jerabaul29/LoggerWavesInIce/Logger_GPS_SD_VN_Binary_output/README.txt

This is a modified version of the code used in 2016, that implements one solution that can be used to perform logging of binary data from the VN100. This could be adapted to log other binary outputs. 

---------------------------------------------------------------
This logger uses:
- the VN100 with binary output
- the GPS with usual serial output
---------------------------------------------------------------

---------------------------------------------------------------
The configuration of the VN100 is:

Baud rate      : 57600
Async          : NoOutput
Binary output 1: 
    Async mode    : Serial Port 1
    Rate dividor  : 80
    Common group  : None
    IMU group     : UncompensatedMag
                    UncompensatedAccel
                    UncompensatedGyro
                    Temp
                    Press
    Attitude group: Yaw Pitch Roll
                    DCM
                    MagNed
                    AccelNed
    IMU filtering : 80
 
 This corresponds to the binary header (in HEX):
 fa 14 3e 00 3a 00
 
 The length of the message is (in byte): 123
 
 Note that the post can have in addition an
 end of line marker (in HEX):
 0a 0d
 ---------------------------------------------------------------
 
 ---------------------------------------------------------------
 To examine the content of the SD card on Linux computer,
 use for example xxd:
 
 tail -x FileName | head -y | xxd
 ---------------------------------------------------------------
 
 ---------------------------------------------------------------
 CAUTION: when using VectorNav software, do not forget to:
 - connect to the sensor
 - write to non volatile memory (right click on the sensor in the tree view)
 - disconnect from the sensor
 ---------------------------------------------------------------
 
 If you use a PCB from a waves in ice instrument, make sure to use the right port for the IMU (need Serial3), make sure to use a core with extended buffers (better to use RX as 512 bytes), and make sure that production loggers have the serial debug disabled.
