jerabaul29/LoggerWavesInIce/InitializeEEPROM/Readme.md

This sketch should be uploaded and run once before an Arduino board will be used for logging. This will initialize the EEPROM memory location used for tracking file numbering.

Once this sketch has been uploaded on the board (and let run once), you can upload the code for the logger on the board.
