jerabaul29/LoggerWavesInIce/Logger_GPS_SD_VN/Readme.md

This is the program uploaded on the Arduino board that was used for performing measurements during the year 2016.
