jerabaul29/LoggerWavesInIce/UserManual/MainManual/Figures/IMG_20170418_100254.jpg

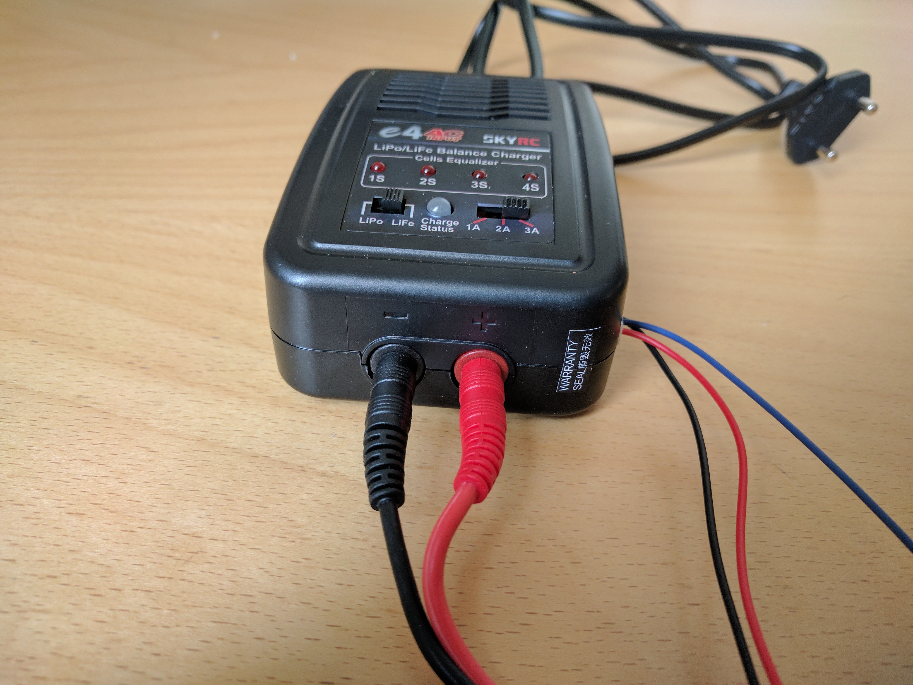
UserManual/MainManual/Figures/IMG_20170418_100254.jpg
