jerabaul29/LoggerWavesInIce/UserManual/MainManual/Figures/IMG_20170418_100300.jpg

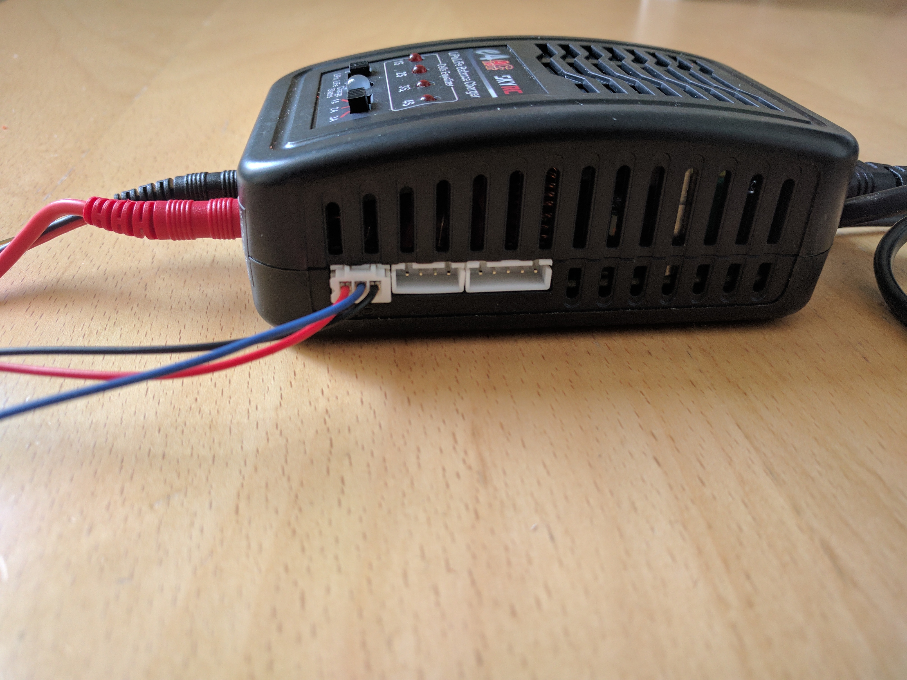
UserManual/MainManual/Figures/IMG_20170418_100300.jpg
