jerabaul29/LoggerWavesInIce/UserManual/MainManual/Figures/IMG_20170418_102035.jpg

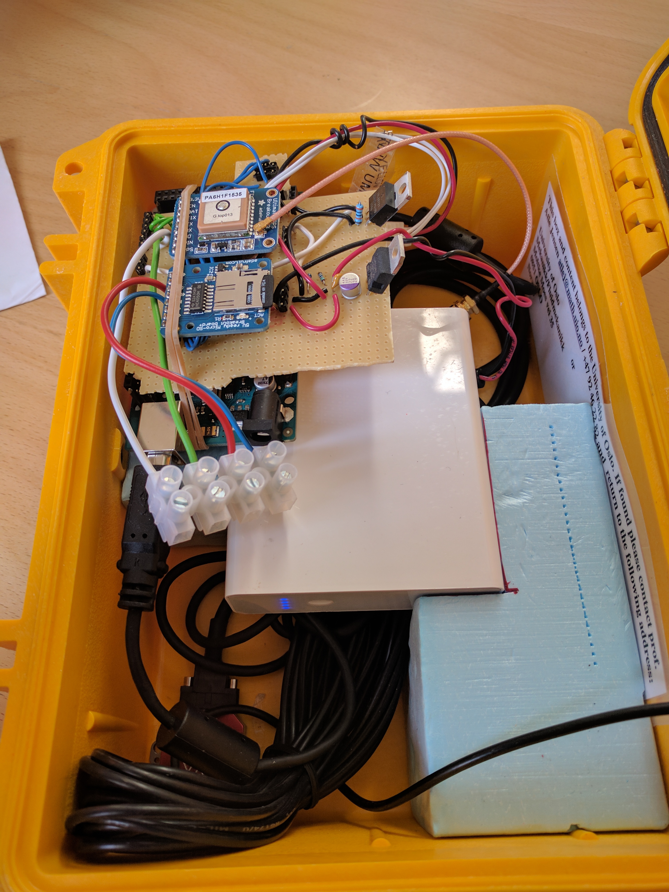
UserManual/MainManual/Figures/IMG_20170418_102035.jpg
