jerabaul29/LoggerWavesInIce/UserManual/MainManual/Figures/IMG_20170418_102041.jpg

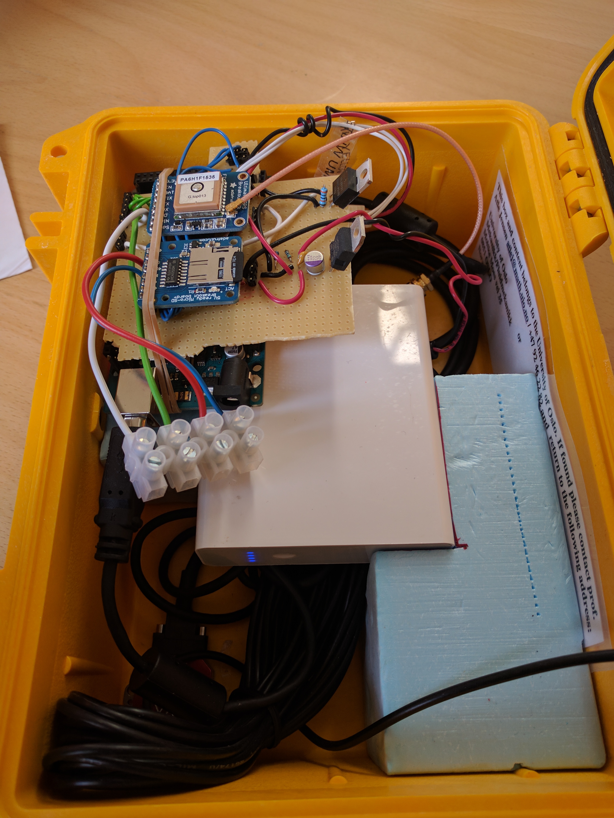
UserManual/MainManual/Figures/IMG_20170418_102041.jpg
