jerabaul29/LoggerWavesInIce/UserManual/MainManual/Figures/IMG_20170418_102318.jpg

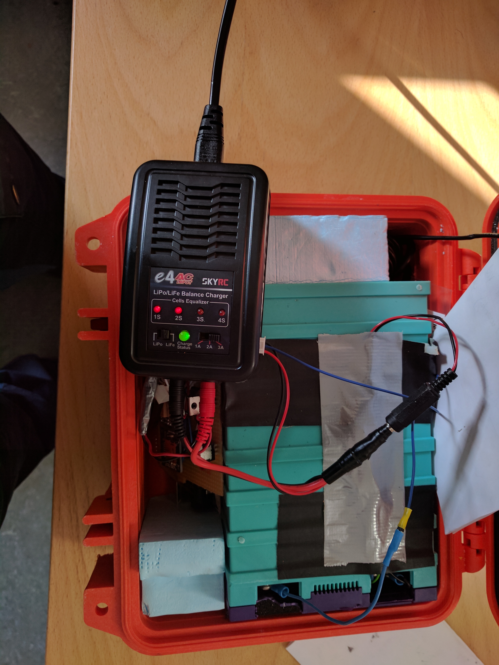
UserManual/MainManual/Figures/IMG_20170418_102318.jpg
