jerabaul29/LoggerWavesInIce/UserManual/MainManual/Figures/IMG_20170418_134233.jpg

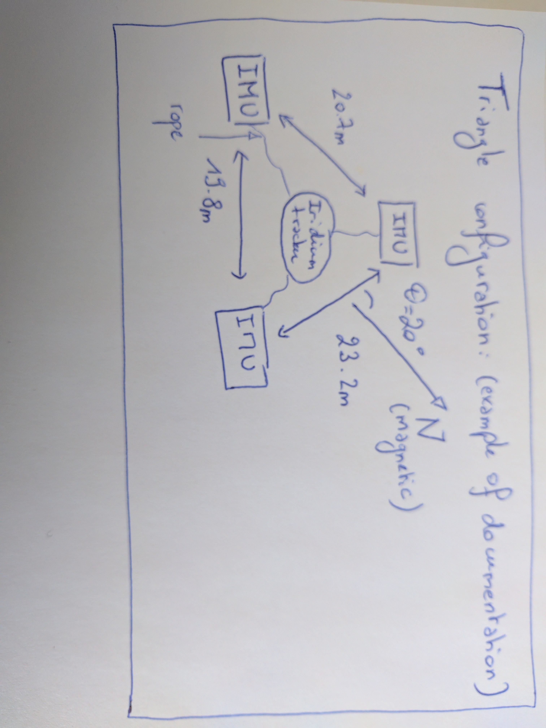
UserManual/MainManual/Figures/IMG_20170418_134233.jpg
