jerabaul29/LoggerWavesInIce/UserManual/MainManual/Figures/IMG_20170418_134344.jpg

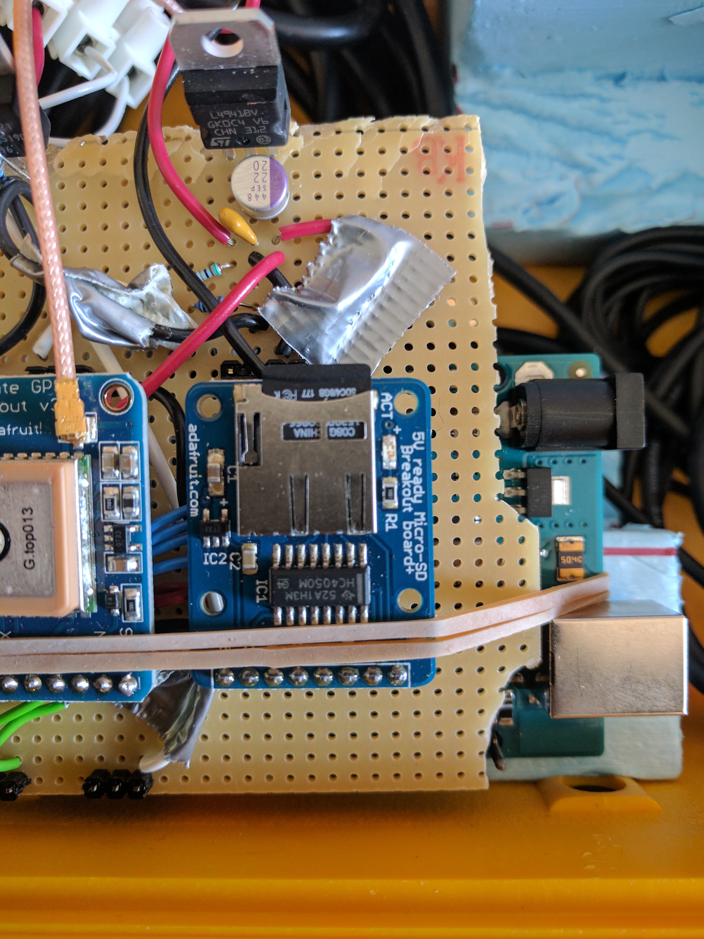
UserManual/MainManual/Figures/IMG_20170418_134344.jpg
