jerabaul29/LoggerWavesInIce/UserManual/MainManual/Figures/IMG_20170418_134644.jpg

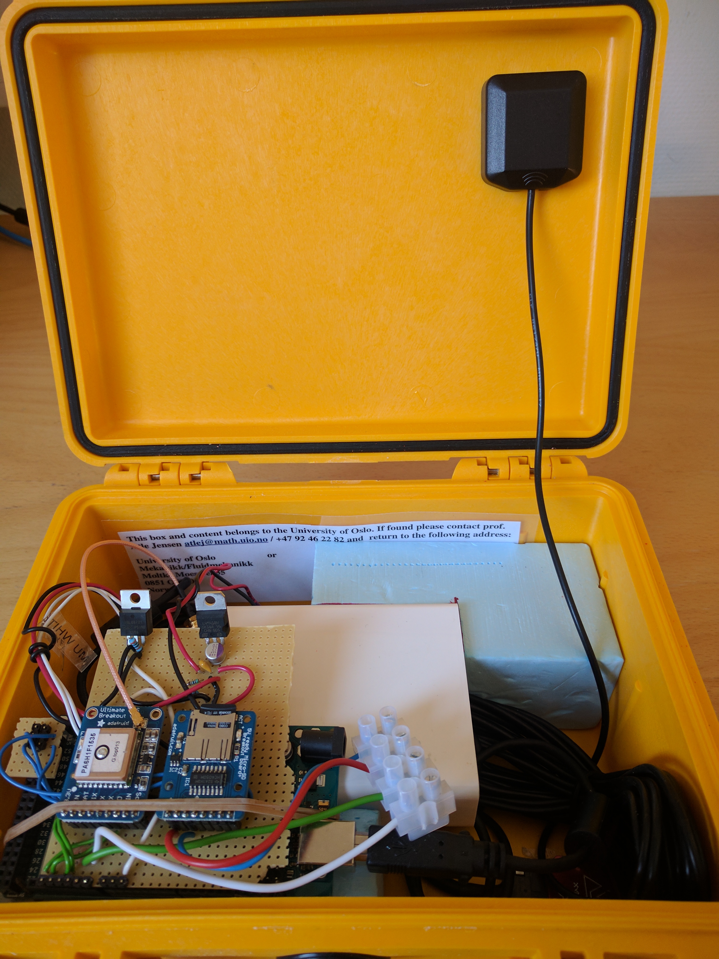
UserManual/MainManual/Figures/IMG_20170418_134644.jpg
