jerabaul29/LoggerWavesInIce/UserManual/MainManual/Figures/IMG_20170418_135347.jpg

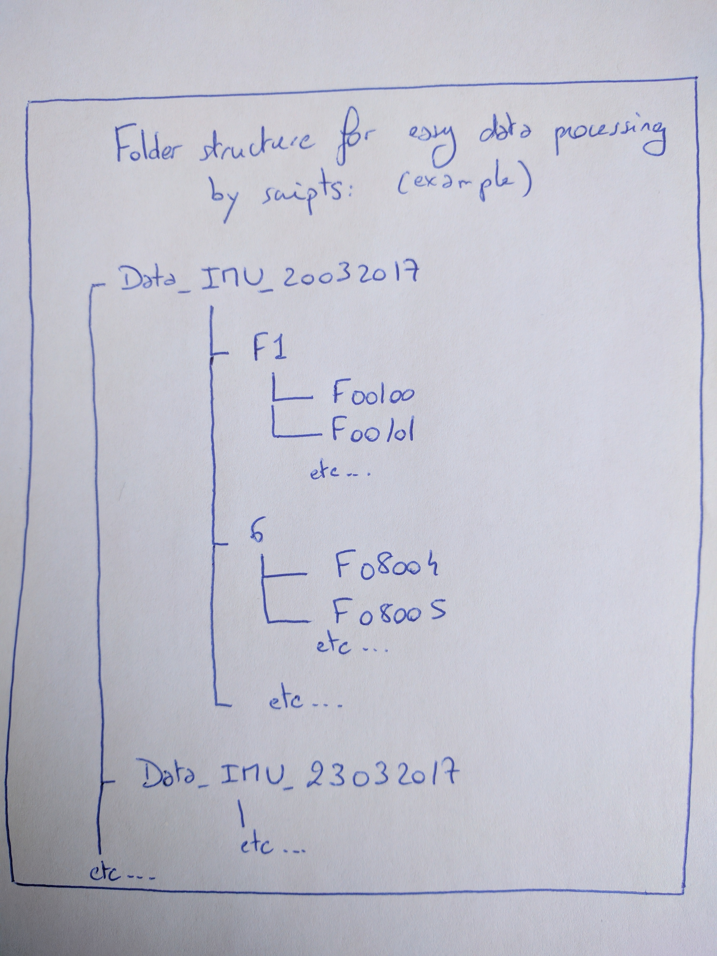
UserManual/MainManual/Figures/IMG_20170418_135347.jpg
