jerabaul29/LoggerWavesInIce/UserManual/MainManual/Figures/IMG_20170418_141828.jpg

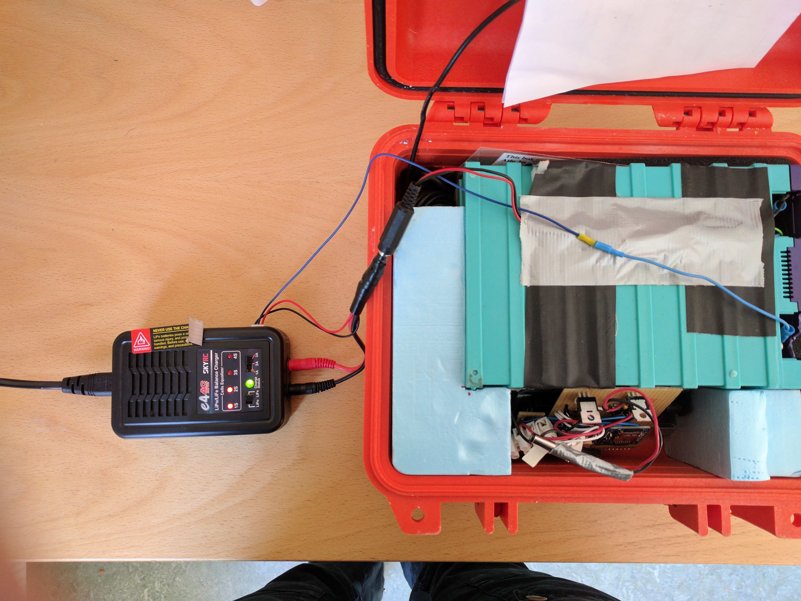
UserManual/MainManual/Figures/IMG_20170418_141828.jpg
