jerabaul29/LoggerWavesInIce/UserManual/MainManual/Figures/IMG_20170418_141833.jpg

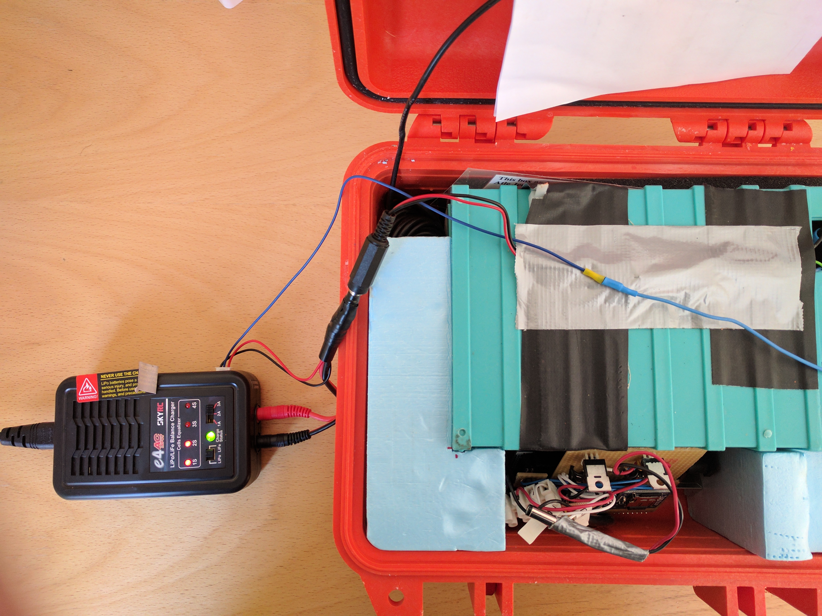
UserManual/MainManual/Figures/IMG_20170418_141833.jpg
