jerabaul29/LoggerWavesInIce/(threads)

Thread 2 (2019-10-20):

Parser

jvoermans, 2019-10-20:
@jerabaul29 Hi Jean, I tried the parser using Python 2.7. Only issue is that running the script with the example data provides nearly empty output files. Only data in the output files are the headers, followed by a single number (a zero). Does "verbose" need any changing?
[OUTPUT_FILES.ZIP](https://github.com/jerabaul29/LoggerWavesInIce/files/3747740/OUTPUT_FILES.ZIP)

jerabaul29, 2019-10-21:
@jvoermans strange. Can you show the full terminal output?

Verbose should not change anything, should be only more or less output in terminal. I had some updates back and forth on this code, will test again on my machine.

jvoermans, 2019-10-21:
@jerabaul29 I reinstalled Anaconda (Spyder) on my personal computer to get Python 2.7 on it.

I actually tried first on the data provided in the folder. The terminal doesn't give much output, so feels like it is not doing any loop or something:

runfile('C:/Users/Joey/.spyder/Test_Parser/test_process_folder.py', wdir='C:/Users/Joey/.spyder/Test_Parser')
Reloaded modules: parser_logger
Processing file: F00294
Processing file: F00379

That's all in the terminal...

jerabaul29, 2019-10-21:
Mmmh, you are on Windows I see... Don't know if that may be your problem. Can you use VMWare or other technique to run from Ubuntu or other Linux distro? Otherwise, can you put the verbose value to 10 and see what comes out?

jvoermans, 2019-10-21:
verbose=10 gives more terminal output, but not in the files

jerabaul29, 2019-10-21:
Can you show it here?

jvoermans, 2019-10-21:
Processing file: F00294
Total data length: 138
Current index: 0
Current next two chars: $G
Hit start of a GPS data string
Message: GPRMC,000012.800,V,,,,,0.00,0.00,060180,,,N*49
Current index: 48
Current next two chars: M,
Hit start of a milliseconds timestamp
Message: 4169
Current index: 55
Newline char
Current index: 56
Current next two chars: B,
Hit start of a binary data frame
Print binary data
Length of binary data as ASCII: 154
14 3e 00 3a 00 71 43 b4 bd 82 c8 a4 bd fb 51 d3 3e 3a 6b 99 bf d8 8a 18 c0 f8 26 16 c1 9c 2f 45 b9 e0 bc 9f b6 1f ba 70 bb 3b a5 9b 41 0f 2d cc 42 6b ed 07 43 50 82 e2 c0 c6 ab 63 41 16 86 36 bf 0b 08 27 bf 49 7a 83 3e 65 b5 30 3f
Validity checksum False
Processing file: F00379
Total data length: 366
Current index: 0
Current next two chars: S,
Hit start of a file
Message: Booting from beginning!
Current index: 26
Newline char
Current index: 27
Current next two chars: R,
Hit start of a raw reading battery message
Message: 0
Current index: 31
Current next two chars: C,
Hit start of a converted level battery message
Message: 0.00
Current index: 38
Current next two chars: M,
Hit start of a milliseconds timestamp
Message: 6865
Current index: 45
Newline char
Current index: 46
Current next two chars: B,
Hit start of a binary data frame
Print binary data
Length of binary data as ASCII: 248
14 3e 00 3a 00 fa 14 3e 00 3a 00 00 00 00 00 00 00 00 00 00 00 00 00 00 00 00 00 00 00 00 00 00 00 00 00 00 00 00 00 00 00 00 00 00 00 00 00 00 00 00 00 00 00 00 00 00 00 00 00 00 00 00 00 00 00 00 00 00 00 00 00 00 00 00 00 00 00 00 00 00 00 00 00 00 00 00 00 00 00 00 00 00 00 00 00 00 00 00 00 00 00 00 00 00 00 00 00 00 00 00 00 00 00 00 00 00 00 00 00 00 00 00 00 0a
Validity checksum False
Current index: 175
Current next two chars: M,
Hit start of a milliseconds timestamp
Message: 7885
Current index: 182
Newline char
Current index: 183
Current next two chars: .0
Broken message, read until next line break
Message: 0,0.00,050180,,,N*44
Current index: 206
Current next two chars: M,
Hit start of a milliseconds timestamp
Message: 7898
Current index: 213
Newline char
Current index: 214
Current next two chars: $G
Hit start of a GPS data string
Message: GPVTG,0.00,T,,M,0.00,N,0.00,K,N*32
Current index: 250
Current next two chars: M,
Hit start of a milliseconds timestamp
Message: 7937
Current index: 257
Newline char
Current index: 258
Current next two chars: B,
Hit start of a binary data frame
Print binary data
Length of binary data as ASCII: 206
14 3e 00 3a 00 7d 7f 57 3e 11 89 2d 3d 78 cb f5 3e 6c 85 1c c0 7b ce ab 3f c0 41 15 c1 22 94 41 3b b3 7a 2c b9 68 15 f2 3b b3 7d f3 40 88 96 cc 42 1b 89 31 c3 fd fc 68 c1 70 1d 03 c1 22 8c 77 bf 4c 60 dd 3b 44 6f 82 3e 56 77 2a bd d6 8b 7d bf 9e dd 06 be 96 ba 80 3e fc 44 0d be 23 3f 75 3f 70 aa 69 3e 02 91
Validity checksum False

jvoermans, 2019-10-21:
Can it be the different path handling between Linux and Windows? From reading on google, it seems to be the main difference right?

jvoermans, 2019-10-21:
I had a Linux user try the parser and it worked, so indeed, Windows seems the problem. Let me see if I can get a Linux subsystem on my computer...

jvoermans, 2019-10-22:
@jerabaul29 Ok it works now! I installed the Windows Subsystem for Linux and went from there.

jerabaul29, 2019-10-22:
Excellent. Conclusion is, I love Linux and hate Windows. Will update the readme later today.

Closed 2019-10-22.

Thread 3 (2019-10-23):

Logger not recording IMU data

jvoermans, 2019-10-23:
@jerabaul29 The logger is not logging any data, only generating empty files. This is what I did, perhaps you can see something I'm missing:

- I disconnected the RaspPi and Iridium modem from the logger.
- I uploaded the sketch "InitializeEEPROM.ino" on the ArduinoMega, waited for a while to let it run
- I uploaded the sketch "Logger_GPS_SD_VN.ino" on the ArduinoMega
- I configured the VN100 using the new Control Center of VectorNAV using following configuration:
-- System>Baud Rate: 57600 (I didn't specify Serial Port here)
-- Async Output Type>Ador: OFF (there is no "no output" here, also Serial Port is kept undefined here)
-- Async Output Freq>Adof: is kept at 40Hz
-- Binary Output Reg. #1> Port: Serial 1
-- Binary Output Reg. #1> Rate Divisor: 80
-- Binary Output Reg. #1>Message>IMU: UnCompMag, UnCompAccel, UnCompGyro, Temperature, Pressure
-- Binary Output Reg. #1>Message>Attitude: Ypr, Dcm, MagNed, AccNed

This gives a RATE of 10Hz, Size of 124 bytes (that is 1 byte more than the 123 of yours), BANDWITH 11900 bps and MESSAGE: $VNWRG,75,1,80,14,003E,003A*6ED3

-- IMU>Imu Filter Control: Mag, Accel, Gyro, Temp, Pres Window Size all set at 80.

Configuration is ended with: Write Settings>Execute

Disconnect and reconnect the IMU shows that all settings were configured.

One comment, the sketch says that the IMU has Serial2, is that something else than the Serial1 mentioned for the settings above? I did try Serial 2 in the settings as well, but didn't change anything with the Arduino output files.

There is also an option to load a configuration, we might try that as well if you have such a file.

If I connect the logger to my computer, the gps blinks normally, but the SD card blinks every 2 seconds with red light.

This is the serial output:

_Booting_

_Time1: 5000
Time2: 5000
card initialized.
GPS initialized
Init VN100 on Serial 2_

_----- End setup -----_

_str_rank: 19
File name: F00019
Start post...
Time log beginning: 6497
post success
Mess,Booting from beginning!
Time log end: 6525
Time log delay: 28
Start post...
Time log beginning: 6528
post success
R,732,CV,5.36
Time log end: 6536
Time log delay: 8_

_Digital in voltage: 732
Battery voltage (no calib.): 5.36
Start post...
Time log beginning: 6636
post success
$GPGGA,235957.800,,,,,0,00,,,M,,M,,*7F
M,6636
Time log end: 6642
Time log delay: 6
Start post...
Time log beginning: 6645
post success
R,575,CV,4.21
Time log end: 6653
Time log delay: 8_

_Digital in voltage: 575
Battery voltage (no calib.): 4.21_

And a little later, the GPS is giving time I guess?

_Start post...
Time log beginning: 151245
post success
$GPRMC,000638.312,V,,,,,0.00,0.00,231019,,,N*48
M,151245
Time log end: 151254
Time log delay: 9
Start post...
Time log beginning: 151258
post success
R,490,CV,3.59
Time log end: 151266
Time log delay: 8_

_Digital in voltage: 490
Battery voltage (no calib.): 3.59_

jerabaul29, 2019-10-23:
Ok, so you uploaded the code for the logger on the instrument board, right? :) Are you using the instrument PCB with the logger code then?

A few things:

- the logger needs the IMU to be in the exact state I mention in the README (it looks like this is not the case currently? For example, the IMU filtering is not set), as it searches for the binary header to check the start of a valid message:

https://github.com/jerabaul29/LoggerWavesInIce/blob/bdcb0b8b306b9d6bfaa67e7240d75cab6b64ff0d/Logger_GPS_SD_VN_Binary_output/Logger_GPS_SD_VN_Binary_output.ino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

So if the VN100 is in a different configuration, the binary header will be different, in which case the messages will not be recognized and the logger will just reboot. You may have a way to check for the binary header in the VN100 software. May you do that and check that your header is well ```fa 14 3e 00 3a 00```. If you want to use a different configuration, with a different header, you will need to change the header definition in the Arduino sketch.

**My recommendation here** is to use the **old** version of the VN100 software (still available on their website), and parameter the VN100 IMU **exactly** as is said in the readme.

- The configuration to use is slightly different between the waves in ice logger and the waves in ice instrument. Indeed, on the PCB of the waves in ice instrument, the VN100 is on the serial port Serial3. So you **do need (necessary condition)** to set the value there:

https://github.com/jerabaul29/LoggerWavesInIce/blob/bdcb0b8b306b9d6bfaa67e7240d75cab6b64ff0d/Logger_GPS_SD_VN_Binary_output/Logger_GPS_SD_VN_Binary_output.ino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

to:

```#define SERIAL_IMU Serial3```

recompile and upload.

- Did you upload the sketch using an extended buffer core for the Arduino Mega? See this:

Upload the right logger code on the Arduino Mega, using an **extended buffer core** (see ArduinoMegaExtendedSerialBuffers for more details).

In the master readme of the repo.

This is also **necessary** for the good functionning of the logger. If you have difficulties using an extended buffer configuration, let me know I will help you. You can first try to either follow the explanations in the corresponding folder, or see on the internet (as the Arduino code architecture may have changed a bit). For example, platformio (if you use visual studio code + the platformio extension, which can be a good idea, there is a simple file where you can change such parameters. On my version of platformio, you can just update the platformio.ini of the project, and put something like:

build_flags = -D SERIAL_RX_BUFFER_SIZE=512 -D SERIAL_TX_BUFFER_SIZE=128

jerabaul29, 2019-10-23:
If anything is unclear, just let me know. When this is sorted out I will update the readmes etc.

jvoermans, 2019-10-23:
Sorry, the terminology is confusing me. Could you rephrase this for me: Ok, so you uploaded the code for the logger on the instrument board, right? :) Are you using the instrument PCB with the logger code then? I detached the arduino from the pcb, and uploaded both ino files on there. Or do I need to do specific handling to do that?

I tried to look for the old software but couldn't find it! Do you have a link for me?

Also confused about Serial3, I don't think in the VectorNav software there was an option for that, only 1 or 2.

I'll give it a go tonight or tmrw morning. If it fails, would you be able to do a skype session to walk me through it?

jerabaul29, 2019-10-23:
I just mean that you use one of the PCBs you assembled, which are 'instruments' PCBs, but you want to use them to run the code of a logger, right? :) I.e. what we discussed last time :) .

- Old version of the VN100 software: here https://www.vectornav.com/support/downloads you can download the 'VectorNav Legacy Libraries' software
```
    VectorNav Sensor Explorer (Windows)
    EXE, 24.64 MB
```

- set to Serial3: this is to be done on the Mega code, not on the VN100. This is because the Arduino Mega has 3 serial ports, and on the PCB of the instrument the VN100 is on Port 3, while the current Arduino sketch for the logger expects Port 2

- I think I remember there is a tool for this somewhere in the VN100 software that allows to compute binary headers, but not sure where. But if you use the old VN100 software and the exact set of parameters I provide, should work.

- Yes, we could organize something like that.

jerabaul29, 2019-10-31:
This is working now, right

For the record this was due to:

- not having programmed the VN100 with the right settings
- not using the right serial port
- not using the extended core

Fixing all 3 points gave good results (dropout 0.4% if I remember well?).

jvoermans, 2019-10-31:
Yes. I tried first a readout of the additional sensors at 1Hz, directly
after the GPS code, but dropouts were 10%, so I just read them out now once
for every record together with voltage readout.

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

jerabaul29, 2019-10-31:
Ok, strange. There must be a way to do it cleanly and get at least a few Hz of logging.

Closed 2019-10-31.

Thread 4 (2019-10-31):

processing scripts

jerabaul29, 2019-10-31:
@jvoermans here are some scripts you may use:

https://github.com/jerabaul29/LoggerWavesInIce/tree/master/processing_scripts

Those are:

- python 2.7
- ugly
- brittle
- not ready for release really

But if you want feel free to play with them.

Please feel free to play around / ask for help. See the Readme for some light explanations.

Note that the code splits your data into several segments, so that each segment is much faster to process (useful if you have 1 month of data, but only a couple of segments a day long or so that contain wave signal).

jerabaul29, 2019-10-31:
PS: I am very much willing to help you clean and organize and document and rationalize the scripts, would be great to have a neat little package by cleaning and improving this bunch of code ;)

jerabaul29, 2023-04-17:
@atlej this can be used for inspiration, though old / ugly / brittle.

atlej, 2023-04-17:
@jerabaul29 Funny. I was in here to look at your scripts. Need to install a lot of python packets...

jerabaul29, 2023-04-17:
It's not thaaaat much, I see much worse every day ^^ :) .

atlej, 2023-04-17:
@jerabaul29 but you write programs every day. I do it maybe every second year

atlej, 2023-04-17:
@jerabaul29 I got lost in the first script->
atlej@Atles-MacBook-Air processing_scripts % python3 split_data_between_folders.py
--------------- spltting F01674_B ---------------
Traceback (most recent call last):
  File "/Users/atlej/Documents/git/LoggerWavesInIce/processing_scripts/split_data_between_folders.py", line 23, in <module>
    list_files = os.listdir(path_to_data_to_split + crrt_dir + "/")
                 ^^^^^^^^^^^^^^^^^^^^^^^^^^^^^^^^^^^^^^^^^^^^^^^^^^
NotADirectoryError: [Errno 20] Not a directory: '/Users/atlej/Documents/UNIS/Svalbard_April_2023/IMU1_parsed/F01674_B/'

jerabaul29, 2023-04-17:
I do not remember much about these scripts, I wrote them in a hurry many years ago.

I think that the problem is that you are providing the "wrong" path: what have you provided as:

https://github.com/jerabaul29/LoggerWavesInIce/blob/ebe820b148fef166da35d8ac7da244327c282f50/processing_scripts/split_data_between_folders.py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

These should be folders (not sure if the parent or parent parent) containing the extracted files, maybe a few levels "above" as this may have been thought to parse several instruments at the same time.

You may need to try and error a bit to find out how "deep" you need to point the script to in the tree structure.

Thread 5 (2020-03-18):

Python 3

trygvekl, 2020-03-18:
Hi @jerabaul29,

I would like to take a look at the IMU data we sampled in Svalbard, but I am not quite sure how to. I have cloned this repository and as I understand it, I first need to parse the data. I tried to run the test_process_folder.py under /LoggerWavesInIce/Logger_GPS_SD_VN_Binary_output_Parser, but I got the following error: UnicodeDecodeError: 'utf-8' codec can't decode byte 0xfa in position 53: invalid start byte. Has this got something to do with the fact that I run Python v 3? I already corrected the print syntax in parser_logger.py to Python 3.

Maybe you can give me a clue on how to proceed here?

Trygve

jerabaul29, 2020-03-18:
Ok. This code should work - I and other people used it several times - , but I am afraid that the different encoding used by python3 breaks things. You can either fix the encoding stuff yourself in the code (for this, see how I fixed it when doing the bow measurements analysis), or (maybe simpler) use python 2 by just using the ```python``` command instead of the ```python3``` command (note: you will need to ```sudo pip``` install all necessary packages, even if they had been ```sudo pip3``` installed for python3 before).

trygvekl, 2020-03-19:
Ok, I'm trying to convert the encoding to python3. I have been able to parse the data, but it is a bit unclear how I should organize the directory tree. I have used only one instrument a couple of hours per day over five days. This gives me typically 15 F0XXXX files per day, in total 67 files. When they are parsed, each file generates 11 new files (F0XXXX_B, etc.). How would you suggest I organize the files with split_data_between_folders.py so that I can best proceed with the further analysis? In process_IMU_data_structure.py, the following tree is suggested (which I find a bit confusing)
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

jerabaul29, 2020-03-19:
Excellent, great to hear parsing worked!

So basically then you have a single IMU folder, and in this folder you have all your FXXXX files. The files with extensions are the parsed data that you can use for your analysis. Once the parsing has been done, you can have a try at the processing scripts here:

https://github.com/jerabaul29/LoggerWavesInIce/tree/master/processing_scripts

Note that:

- these scripts were developed for looking at much larger amounts of data from more instruments than you have, so you can probably ignore quite a lot of them

- as a consequence, you should only take the scripts as some inspiration / suggestions of how to do your processing.

Note also that the different files are quickly explained in the readme here:

https://github.com/jerabaul29/LoggerWavesInIce/tree/master/Logger_GPS_SD_VN_Binary_output_Parser

If anything is unclear, looking at the code is the documentation in the present case:

https://github.com/jerabaul29/LoggerWavesInIce/blob/0d08f0d129482b25e651786e4eda92d95e46b9a8/Logger_GPS_SD_VN_Binary_output_Parser/parser_logger.py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

trygvekl, 2020-03-20:
Thanks for the help and for the comments. I'm not sure if the parsing worked properly, because the only files with extensions containing any data are FXXXXX_B (196 B) and FXXXXX_P (approx 3.7 MB), all the other extensions for each file seems to be empty. Is this how it is suppose to be?

From the readme you refer to, I understand it as one need to run the scripts in processing_scrips in a certain order. After the parsing is done one need to run prepare_data_damping.py. This complains a bit about the file extensions being empty and then stops with the following error:
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

jerabaul29, 2020-03-20:
Ok, we can discuss this at the meeting in a few minutes :)

trygvekl, 2020-03-20:
Python 2 works, thank you for the advice!

jerabaul29, 2020-03-20:
Perfect, great to hear! :)

jerabaul29, 2020-03-20:
Working now so closing, feel free to open new issues if you have other problems / questions.

Closed 2020-03-20.

Thread 6 (2020-08-11):

Output

jvoermans, 2020-08-11:
@jerabaul29
Could you confirm the parser output for me? Is the MagXYZ, AccXYZ and GyroXYZ the raw data, DCM the rotation matrix and YPR, MagNED and AccNED (North-East-Down) the earth-frame of reference data?
And what are the units of YPR?

jerabaul29, 2020-08-12:
Hi,

First a small note: these quantities are described in the datasheet if you need more information :)

https://github.com/jerabaul29/LoggerWavesInIce/blob/master/VN100manual.pdf

Regarding your questions:

- yes, XYZ are raw data in the IMU frame of reference
- yes, DCM is the rotation matrix. I have not used it much though.
- yes, NED is in the Earth-frame of reference. This is usually the data I use myself :)
- YPR is Yaw Pich Roll, these are in degrees, according to the datasheet p. 95/129:

"
Attitude solution as yaw, pitch, and roll in degrees.The yaw, pitch, and roll is given as a 3,2,1 Euler angle rotation sequence describing the orientation of the sensor with respect to the inertial North East Down (NED) **frame
"

Does this answer your questions? Let me know if anything is unclear :) . Were you able to successfully run the code? :) .

jvoermans, 2020-08-12:
Thanks. Parsing worked perfect, but Windows was doing difficult with the other scripts (some directory problems). I tried to figure it out for a bit, but diverted to Matlab and have rewritten the few lines of code. Get the same results as the spectrum transmitted, so that should be fine :) I'll upload the Matlab file when I'm done.

One point of confusion, the vertical axis is defined positive downwards, which is corrected to positive upwards in the surface elevation timeseries by the minus-sign in:  elev = -np.real(np.fft.ifft(2 * Yf)) (line 143 of 'look_at_damping.py')? But the timeseries of vertical acceleration are all around -9.81, suggesting that the vertical axis is actually positive upwards?

jerabaul29, 2020-08-12:
This is great to hear! :)

Yes, I expect this does not work well on windows. The reason is that I only develop on linux, and I do not care of using the 'right' method for paths (which is also quite a bit longer to write), for example using ```os.path.join(base_path, file)```, instead I usually write the much shorter ```base_path + "/" + file```, which is fine on linux, as ```/``` is the file delimiter there, but not on windows, which uses ```\``` usually as a path delimiter. Consider running on either linux, or use the linux subsystem for windows in some folders using the unix convention for path delimiters, if this is possible to do (not an expert on that :) ).

That sounds good. I prefer python myself of course, but if you want to provide some matlab stuff, and want to push it to the repo, that may be great to other users :) Feel free to clone / create a feature branch / create a pull request (if you are not familiar with the workflow, feel free to google and / or open an issue asking for some help here :) ).

Mmh, indeed this is always confusing, and difficult to debug, as obtaining +elevation or -elevation (if there is a sign mistake) has no influence on the spectra, SWH, Tp etc... I think that: 1) orientation is indeed upwards, 2) we are interested in the wave acceleration, which is the opposite of the acceleration felt by the sensor.

It is actually always a bit tricky (I had a lot of headaches getting it to work there for example, same issue for rotation :) ): https://github.com/jerabaul29/IntegrateGyroData . Basically the idea is that if the IMU feels an acceleration -A, depending on the conventions used, that are dependent on the chip, that may mean that the object is accelerating in the direction +A. Think about it this way: if the X axis is upwards, and gravity is reported as -9.81, then accelerating upwards with make you feel like "stronger gravity", i.e. more negative vertical acceleration, for example -12.81, i.e. the IMU "feels" an additional acceleration of -3, but really the object is accelerating upwards. That may mean that converting from IMU acceleration feeling to object acceleration in the coordinate system, you need to have some - signs here and there. Does that make sense / is that clear? :)

jvoermans, 2020-08-12:
Thanks, I think I understand it now

Closed 2020-08-12.
