jerabaul29/LoggerWavesInIce/(commit log)

2016-12-21 commit with initial material
2017-03-20 fixed an end-of-line bug in the parser happening when bad luck with hard power reset
